Altairu/Altair-Nexus-Driver-Module/image.png

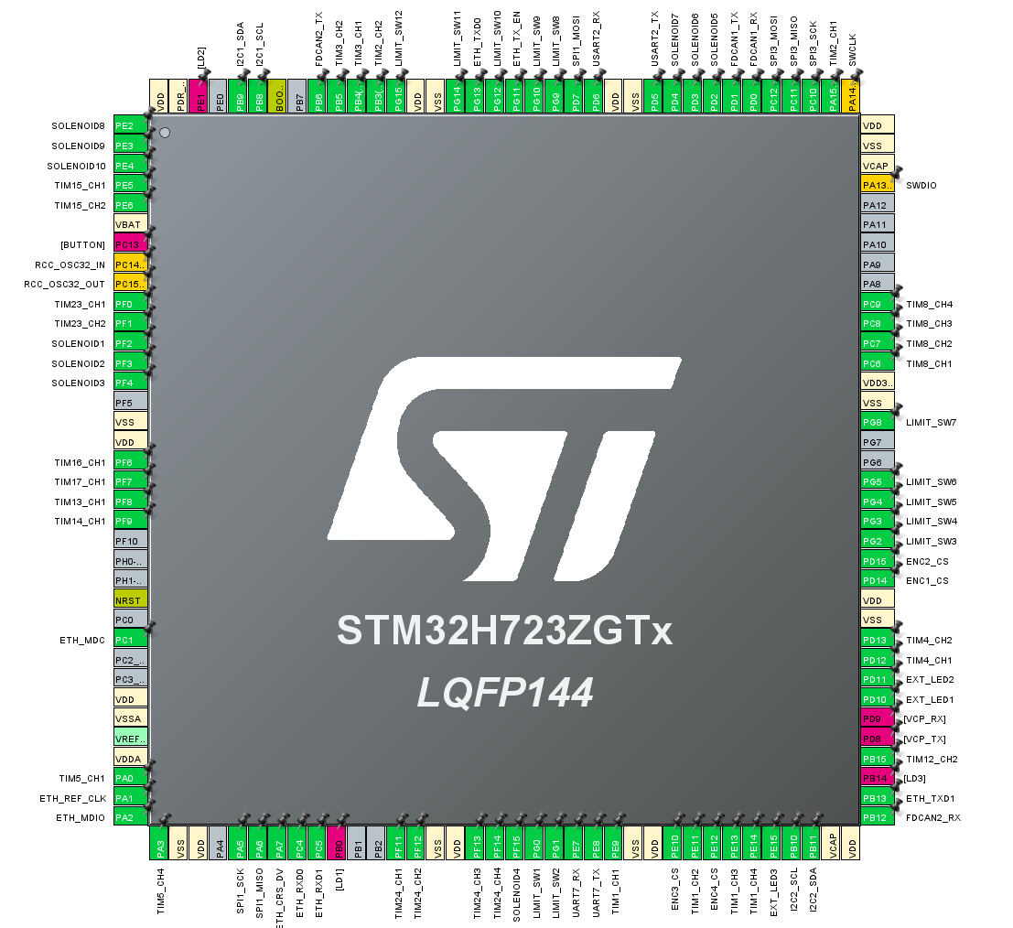
image.png
