Altairu/Altair-Nexus-Driver-Module/circuit/Altair Nexus Driver Module.kicad_sch

## KiCad design circuit/Altair Nexus Driver Module.kicad_sch (2026-10-21)

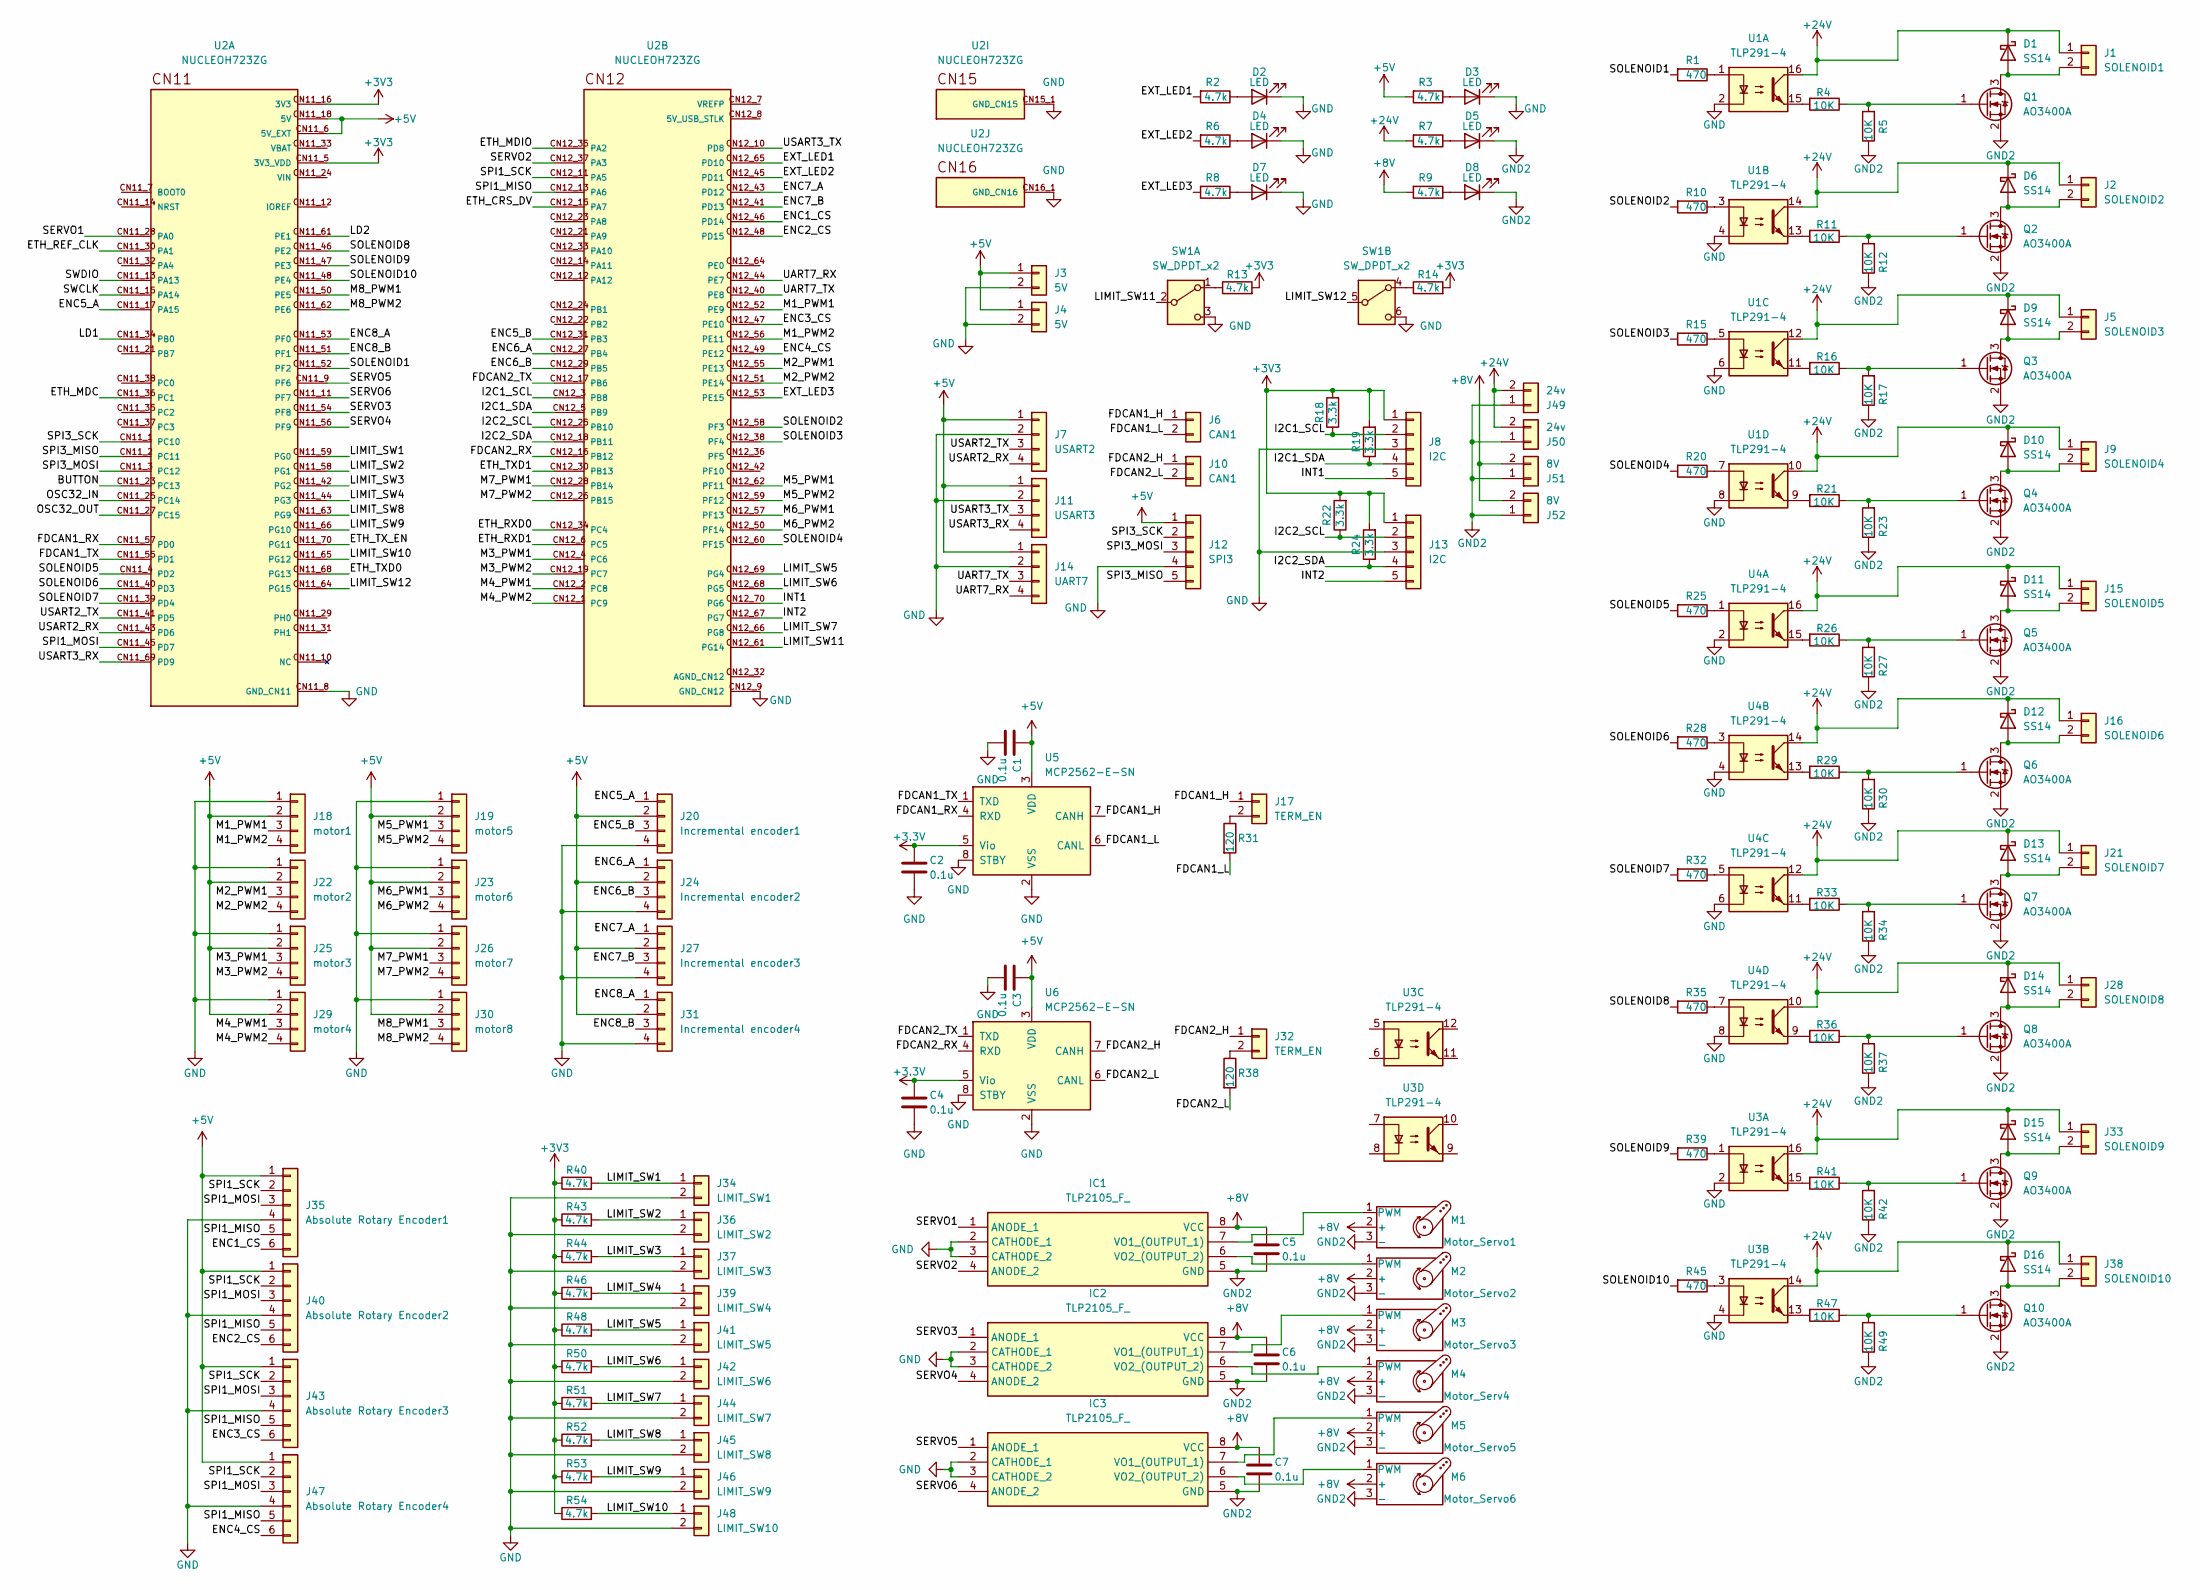
[picture p3: schematic Altair Nexus Driver Module.kicad_sch]

Parts:
C1, C2, C3, C4, C5, C6, C7: 0.1u; C_0603_1608Metric
D1, D6, D9, D10, D11, D12, D13, D14, D15, D16: SS14; D_SMA
D2, D3, D4, D5, D7, D8: LED
IC1, IC2, IC3: TLP2105_F_; TLP2105; Manufacturer_Part_Number TLP2105(F); Mouser Part Number 757-TLP2105(F)
J1: SOLENOID1; AMASS_XT30U-F_1x02_P5.0mm_Vertical
J2: SOLENOID2; AMASS_XT30U-F_1x02_P5.0mm_Vertical
J3, J4: 5V
J5: SOLENOID3; AMASS_XT30U-F_1x02_P5.0mm_Vertical
J6, J10: CAN1
J7: USART2
J8, J13: I2C
J9: SOLENOID4; AMASS_XT30U-F_1x02_P5.0mm_Vertical
J11: USART3
J12: SPI3
J14: UART7
J15: SOLENOID5; AMASS_XT30U-F_1x02_P5.0mm_Vertical
J16: SOLENOID6; AMASS_XT30U-F_1x02_P5.0mm_Vertical
J17, J32: TERM_EN; PinSocket_1x02_P2.54mm_Vertical
J18: motor1
J19: motor5
J20: Incremental encoder1
J21: SOLENOID7; AMASS_XT30U-F_1x02_P5.0mm_Vertical
J22: motor2
J23: motor6
J24: Incremental encoder2
J25: motor3
J26: motor7
J27: Incremental encoder3
J28: SOLENOID8; AMASS_XT30U-F_1x02_P5.0mm_Vertical
J29: motor4
J30: motor8
J31: Incremental encoder4
J33: SOLENOID9; AMASS_XT30U-F_1x02_P5.0mm_Vertical
J34: LIMIT_SW1
J35: Absolute Rotary Encoder1
J36: LIMIT_SW2
J37: LIMIT_SW3
J38: SOLENOID10; AMASS_XT30U-F_1x02_P5.0mm_Vertical
J39: LIMIT_SW4
J40: Absolute Rotary Encoder2
J41: LIMIT_SW5
J42: LIMIT_SW6
J43: Absolute Rotary Encoder3
J44: LIMIT_SW7
J45: LIMIT_SW8
J46: LIMIT_SW9
J47: Absolute Rotary Encoder4
J48: LIMIT_SW10
J49, J50: 24v
J51, J52: 8V
M1: Motor_Servo1; JST_XA_S03B-XASK-1_1x03_P2.50mm_Horizontal
M2: Motor_Servo2; JST_XA_S03B-XASK-1_1x03_P2.50mm_Horizontal
M3: Motor_Servo3; JST_XA_S03B-XASK-1_1x03_P2.50mm_Horizontal
M4: Motor_Serv4; JST_XA_S03B-XASK-1_1x03_P2.50mm_Horizontal
M5: Motor_Servo5; JST_XA_S03B-XASK-1_1x03_P2.50mm_Horizontal
M6: Motor_Servo6; JST_XA_S03B-XASK-1_1x03_P2.50mm_Horizontal
Q1, Q2, Q3, Q4, Q5, Q6, Q7, Q8, Q9, Q10: AO3400A; SOT-23
R1, R10, R15, R20, R25, R28, R32, R35, R39, R45: 470; R_0603_1608Metric
R2, R3, R6, R7, R8, R9: 4.7k; R_0603_1608Metric
R4, R5, R11, R12, R16, R17, R21, R23, R26, R27, R29, R30, R33, R34, R36, R37, R41, R42, R47, R49: 10K; R_0603_1608Metric
R13, R14, R40, R43, R44, R46, R48, R50, R51, R52, R53, R54: 4.7k
R18, R19, R22, R24: 3.3k
R31, R38: 120; R_0603_1608Metric
SW1: SW_DPDT_x2
U1, U3, U4: TLP291-4; SOIC-16_4.55x10.3mm_P1.27mm
U2: NUCLEOH723ZG; MODULE_NUCLEOH723ZG; PARTREV 2
U5, U6: MCP2562-E-SN; SOIC-8_3.9x4.9mm_P1.27mm

Connections:
+3.3V: C2.1, C4.1, U5.5 (Vio), U6.5 (Vio)
+3V3: J8.1, J13.1, R13.2, R14.2, R18.2, R19.2, R22.2, R24.2, R40.1, R43.1, R44.1, R46.1, R48.1, R50.1, R51.1, R52.1, R53.1, R54.1, U2.CN11_5 (3V3_VDD), U2.CN11_16 (3V3)
+5V: C1.1, C3.1, J3.1, J4.1, J7.1, J11.1, J12.1, J14.1, J18.2, J19.2, J20.2, J22.2, J23.2, J24.2, J25.2, J26.2, J27.2, J29.2, J30.2, J31.2, J35.1, J40.1, J43.1, J47.1, R3.2, U2.CN11_6 (5V_EXT), U2.CN11_18 (5V), U5.3 (VDD), U6.3 (VDD)
+8V: C5.1, C6.1, C7.1, IC1.8 (VCC), IC2.8 (VCC), IC3.8 (VCC), J51.2, J52.2, M1.2 (+), M2.2 (+), M3.2 (+), M4.2 (+), M5.2 (+), M6.2 (+), R9.2
+24V: D1.1 (K), D6.1 (K), D9.1 (K), D10.1 (K), D11.1 (K), D12.1 (K), D13.1 (K), D14.1 (K), D15.1 (K), D16.1 (K), J1.1, J2.1, J5.1, J9.1, J15.1, J16.1, J21.1, J28.1, J33.1, J38.1, J49.2, J50.2, R7.2, U1.10, U1.12, U1.14, U1.16, U3.14, U3.16, U4.10, U4.12, U4.14, U4.16
BUTTON: U2.CN11_23 (PC13)
ENC1_CS: J35.6, U2.CN12_46 (PD14)
ENC2_CS: J40.6, U2.CN12_48 (PD15)
ENC3_CS: J43.6, U2.CN12_47 (PE10)
ENC4_CS: J47.6, U2.CN12_49 (PE12)
ENC5_A: J20.1, U2.CN11_17 (PA15)
ENC5_B: J20.3, U2.CN12_31 (PB3)
ENC6_A: J24.1, U2.CN12_27 (PB4)
ENC6_B: J24.3, U2.CN12_29 (PB5)
ENC7_A: J27.1, U2.CN12_43 (PD12)
ENC7_B: J27.3, U2.CN12_41 (PD13)
ENC8_A: J31.1, U2.CN11_53 (PF0)
ENC8_B: J31.3, U2.CN11_51 (PF1)
ETH_CRS_DV: U2.CN12_15 (PA7)
ETH_MDC: U2.CN11_36 (PC1)
ETH_MDIO: U2.CN12_35 (PA2)
ETH_REF_CLK: U2.CN11_30 (PA1)
ETH_RXD0: U2.CN12_34 (PC4)
ETH_RXD1: U2.CN12_6 (PC5)
ETH_TXD0: U2.CN11_68 (PG13)
ETH_TXD1: U2.CN12_30 (PB13)
ETH_TX_EN: U2.CN11_70 (PG11)
EXT_LED1: R2.2, U2.CN12_65 (PD10)
EXT_LED2: R6.2, U2.CN12_45 (PD11)
EXT_LED3: R8.2, U2.CN12_53 (PE15)
FDCAN1_H: J6.1, J17.1, U5.7 (CANH)
FDCAN1_L: J6.2, R31.2, U5.6 (CANL)
FDCAN1_RX: U2.CN11_57 (PD0), U5.4 (RXD)
FDCAN1_TX: U2.CN11_55 (PD1), U5.1 (TXD)
FDCAN2_H: J10.1, J32.1, U6.7 (CANH)
FDCAN2_L: J10.2, R38.2, U6.6 (CANL)
FDCAN2_RX: U2.CN12_16 (PB12), U6.4 (RXD)
FDCAN2_TX: U2.CN12_17 (PB6), U6.1 (TXD)
GND: C1.2, C2.2, C3.2, C4.2, D2.1 (K), D3.1 (K), D4.1 (K), D7.1 (K), IC1.2 (CATHODE_1), IC1.3 (CATHODE_2), IC2.2 (CATHODE_1), IC2.3 (CATHODE_2), IC3.2 (CATHODE_1), IC3.3 (CATHODE_2), J3.2, J4.2, J7.2, J8.3, J11.2, J12.4, J13.3, J14.2, J18.1, J19.1, J20.4, J22.1, J23.1, J24.4, J25.1, J26.1, J27.4, J29.1, J30.1, J31.4, J34.2, J35.4, J36.2, J37.2, J39.2, J40.4, J41.2, J42.2, J43.4, J44.2, J45.2, J46.2, J47.4, J48.2, SW1.3 (C), SW1.6 (C), U1.2, U1.4, U1.6, U1.8, U2.CN11_8 (GND_CN11), U2.CN11_19 (GND_CN11), U2.CN11_20 (GND_CN11), U2.CN11_22 (GND_CN11), U2.CN11_49 (GND_CN11), U2.CN11_60 (GND_CN11), U2.CN12_9 (GND_CN12), U2.CN12_20 (GND_CN12), U2.CN12_39 (GND_CN12), U2.CN12_54 (GND_CN12), U2.CN12_63 (GND_CN12), U2.CN15_1 (GND_CN15), U2.CN15_2 (GND_CN15), U2.CN16_1 (GND_CN16), U2.CN16_2 (GND_CN16), U3.2, U3.4, U4.2, U4.4, U4.6, U4.8, U5.2 (VSS), U5.8 (STBY), U6.2 (VSS), U6.8 (STBY)
GND2: C5.2, C6.2, C7.2, D5.1 (K), D8.1 (K), IC1.5 (GND), IC2.5 (GND), IC3.5 (GND), J49.1, J50.1, J51.1, J52.1, M1.3 (-), M2.3 (-), M3.3 (-), M4.3 (-), M5.3 (-), M6.3 (-), Q1.2 (S), Q2.2 (S), Q3.2 (S), Q4.2 (S), Q5.2 (S), Q6.2 (S), Q7.2 (S), Q8.2 (S), Q9.2 (S), Q10.2 (S), R5.1, R12.1, R17.1, R23.1, R27.1, R30.1, R34.1, R37.1, R42.1, R49.1
I2C1_SCL: J8.2, R18.1, U2.CN12_3 (PB8)
I2C1_SDA: J8.4, R19.1, U2.CN12_5 (PB9)
I2C2_SCL: J13.2, R22.1, U2.CN12_25 (PB10)
I2C2_SDA: J13.4, R24.1, U2.CN12_18 (PB11)
INT1: J8.5, U2.CN12_70 (PG6)
INT2: J13.5, U2.CN12_67 (PG7)
LD1: U2.CN11_34 (PB0)
LD2: U2.CN11_61 (PE1)
LIMIT_SW1: J34.1, R40.2, U2.CN11_59 (PG0)
LIMIT_SW2: J36.1, R43.2, U2.CN11_58 (PG1)
LIMIT_SW3: J37.1, R44.2, U2.CN11_42 (PG2)
LIMIT_SW4: J39.1, R46.2, U2.CN11_44 (PG3)
LIMIT_SW5: J41.1, R48.2, U2.CN12_69 (PG4)
LIMIT_SW6: J42.1, R50.2, U2.CN12_68 (PG5)
LIMIT_SW7: J44.1, R51.2, U2.CN12_66 (PG8)
LIMIT_SW8: J45.1, R52.2, U2.CN11_63 (PG9)
LIMIT_SW9: J46.1, R53.2, U2.CN11_66 (PG10)
LIMIT_SW10: J48.1, R54.2, U2.CN11_65 (PG12)
LIMIT_SW11: SW1.2 (B), U2.CN12_61 (PG14)
LIMIT_SW12: SW1.5 (B), U2.CN11_64 (PG15)
M1_PWM1: J18.3, U2.CN12_52 (PE9)
M1_PWM2: J18.4, U2.CN12_56 (PE11)
M2_PWM1: J22.3, U2.CN12_55 (PE13)
M2_PWM2: J22.4, U2.CN12_51 (PE14)
M3_PWM1: J25.3, U2.CN12_4 (PC6)
M3_PWM2: J25.4, U2.CN12_19 (PC7)
M4_PWM1: J29.3, U2.CN12_2 (PC8)
M4_PWM2: J29.4, U2.CN12_1 (PC9)
M5_PWM1: J19.3, U2.CN12_62 (PF11)
M5_PWM2: J19.4, U2.CN12_59 (PF12)
M6_PWM1: J23.3, U2.CN12_57 (PF13)
M6_PWM2: J23.4, U2.CN12_50 (PF14)
M7_PWM1: J26.3, U2.CN12_28 (PB14)
M7_PWM2: J26.4, U2.CN12_26 (PB15)
M8_PWM1: J30.3, U2.CN11_50 (PE5)
M8_PWM2: J30.4, U2.CN11_62 (PE6)
unnamed: D1.2 (A), J1.2, Q1.3 (D)
unnamed: D2.2 (A), R2.1
unnamed: D3.2 (A), R3.1
unnamed: D4.2 (A), R6.1
unnamed: D5.2 (A), R7.1
unnamed: D6.2 (A), J2.2, Q2.3 (D)
unnamed: D7.2 (A), R8.1
unnamed: D8.2 (A), R9.1
unnamed: D9.2 (A), J5.2, Q3.3 (D)
unnamed: D10.2 (A), J9.2, Q4.3 (D)
unnamed: D11.2 (A), J15.2, Q5.3 (D)
unnamed: D12.2 (A), J16.2, Q6.3 (D)
unnamed: D13.2 (A), J21.2, Q7.3 (D)
unnamed: D14.2 (A), J28.2, Q8.3 (D)
unnamed: D15.2 (A), J33.2, Q9.3 (D)
unnamed: D16.2 (A), J38.2, Q10.3 (D)
unnamed: IC1.6 (VO2_(OUTPUT_2)), M2.1 (PWM)
unnamed: IC1.7 (VO1_(OUTPUT_1)), M1.1 (PWM)
unnamed: IC2.6 (VO2_(OUTPUT_2)), M4.1 (PWM)
unnamed: IC2.7 (VO1_(OUTPUT_1)), M3.1 (PWM)
unnamed: IC3.6 (VO2_(OUTPUT_2)), M6.1 (PWM)
unnamed: IC3.7 (VO1_(OUTPUT_1)), M5.1 (PWM)
unnamed: J17.2, R31.1
unnamed: J32.2, R38.1
unnamed: Q1.1 (G), R4.1, R5.2
unnamed: Q2.1 (G), R11.1, R12.2
unnamed: Q3.1 (G), R16.1, R17.2
unnamed: Q4.1 (G), R21.1, R23.2
unnamed: Q5.1 (G), R26.1, R27.2
unnamed: Q6.1 (G), R29.1, R30.2
unnamed: Q7.1 (G), R33.1, R34.2
unnamed: Q8.1 (G), R36.1, R37.2
unnamed: Q9.1 (G), R41.1, R42.2
unnamed: Q10.1 (G), R47.1, R49.2
unnamed: R1.1, U1.1
unnamed: R4.2, U1.15
unnamed: R10.1, U1.3
unnamed: R11.2, U1.13
unnamed: R13.1, SW1.1 (A)
unnamed: R14.1, SW1.4 (A)
unnamed: R15.1, U1.5
unnamed: R16.2, U1.11
unnamed: R20.1, U1.7
unnamed: R21.2, U1.9
unnamed: R25.1, U4.1
unnamed: R26.2, U4.15
unnamed: R28.1, U4.3
unnamed: R29.2, U4.13
unnamed: R32.1, U4.5
unnamed: R33.2, U4.11
unnamed: R35.1, U4.7
unnamed: R36.2, U4.9
unnamed: R39.1, U3.1
unnamed: R41.2, U3.15
unnamed: R45.1, U3.3
unnamed: R47.2, U3.13
unnamed: U2.CN11_10 (NC), U2.CN11_26 (NC), U2.CN11_67 (NC)
OSC32_IN: U2.CN11_25 (PC14)
OSC32_OUT: U2.CN11_27 (PC15)
SERVO1: IC1.1 (ANODE_1), U2.CN11_28 (PA0)
SERVO2: IC1.4 (ANODE_2), U2.CN12_37 (PA3)
SERVO3: IC2.1 (ANODE_1), U2.CN11_54 (PF8)
SERVO4: IC2.4 (ANODE_2), U2.CN11_56 (PF9)
SERVO5: IC3.1 (ANODE_1), U2.CN11_9 (PF6)
SERVO6: IC3.4 (ANODE_2), U2.CN11_11 (PF7)
SOLENOID1: R1.2, U2.CN11_52 (PF2)
SOLENOID2: R10.2, U2.CN12_58 (PF3)
SOLENOID3: R15.2, U2.CN12_38 (PF4)
SOLENOID4: R20.2, U2.CN12_60 (PF15)
SOLENOID5: R25.2, U2.CN11_4 (PD2)
SOLENOID6: R28.2, U2.CN11_40 (PD3)
SOLENOID7: R32.2, U2.CN11_39 (PD4)
SOLENOID8: R35.2, U2.CN11_46 (PE2)
SOLENOID9: R39.2, U2.CN11_47 (PE3)
SOLENOID10: R45.2, U2.CN11_48 (PE4)
SPI1_MISO: J35.5, J40.5, J43.5, J47.5, U2.CN12_13 (PA6)
SPI1_MOSI: J35.3, J40.3, J43.3, J47.3, U2.CN11_45 (PD7)
SPI1_SCK: J35.2, J40.2, J43.2, J47.2, U2.CN12_11 (PA5)
SPI3_MISO: J12.5, U2.CN11_2 (PC11)
SPI3_MOSI: J12.3, U2.CN11_3 (PC12)
SPI3_SCK: J12.2, U2.CN11_1 (PC10)
SWCLK: U2.CN11_15 (PA14)
SWDIO: U2.CN11_13 (PA13)
UART7_RX: J14.4, U2.CN12_44 (PE7)
UART7_TX: J14.3, U2.CN12_40 (PE8)
USART2_RX: J7.4, U2.CN11_43 (PD6)
USART2_TX: J7.3, U2.CN11_41 (PD5)
USART3_RX: J11.4, U2.CN11_69 (PD9)
USART3_TX: J11.3, U2.CN12_10 (PD8)
