Altairu/Altair-Nexus-Driver-Module/firmware/Altair_Nexus_Driver_Module/Altair_Nexus_Driver_Module.ioc

Mcu.UserName=STM32H723ZGTx
PA0.Signal=S_TIM5_CH1
PA1.Signal=ETH_REF_CLK
PA13(JTMS/SWDIO).GPIO_Label=SWDIO
PA13(JTMS/SWDIO).Signal=DEBUG_JTMS-SWDIO
PA14(JTCK/SWCLK).GPIO_Label=SWCLK
PA14(JTCK/SWCLK).Signal=DEBUG_JTCK-SWCLK
PA15(JTDI).Signal=S_TIM2_CH1_ETR
PA2.Signal=ETH_MDIO
PA3.Signal=S_TIM5_CH4
PA5.Signal=SPI1_SCK
PA6.Signal=SPI1_MISO
PA7.Signal=ETH_CRS_DV
PB0.Signal=GPIO_Output
PB10.Signal=I2C2_SCL
PB11.Signal=I2C2_SDA
PB12.Signal=FDCAN2_RX
PB13.Signal=ETH_TXD1
PB14.Signal=S_TIM12_CH1
PB15.Signal=S_TIM12_CH2
PB3(JTDO/TRACESWO).Signal=S_TIM2_CH2
PB4(NJTRST).Signal=S_TIM3_CH1
PB5.Signal=S_TIM3_CH2
PB6.Signal=FDCAN2_TX
PB8.Signal=I2C1_SCL
PB9.Signal=I2C1_SDA
PC1.Signal=ETH_MDC
PC10.Signal=SPI3_SCK
PC11.Signal=SPI3_MISO
PC12.Signal=SPI3_MOSI
PC13.Signal=GPIO_Input
PC14-OSC32_IN.Signal=RCC_OSC32_IN
PC15-OSC32_OUT.Signal=RCC_OSC32_OUT
PC4.Signal=ETH_RXD0
PC5.Signal=ETH_RXD1
PC6.Signal=S_TIM8_CH1
PC7.Signal=S_TIM8_CH2
PC8.Signal=S_TIM8_CH3
PC9.Signal=S_TIM8_CH4
PD0.Signal=FDCAN1_RX
PD1.Signal=FDCAN1_TX
PD10.GPIO_Label=EXT_LED1
PD10.Signal=GPIO_Output
PD11.GPIO_Label=EXT_LED2
PD11.Signal=GPIO_Output
PD12.Signal=S_TIM4_CH1
PD13.Signal=S_TIM4_CH2
PD14.GPIO_Label=ENC1_CS
PD14.Signal=GPIO_Output
PD15.GPIO_Label=ENC2_CS
PD15.Signal=GPIO_Output
PD2.GPIO_Label=SOLENOID5
PD2.Signal=GPIO_Output
PD3.GPIO_Label=SOLENOID6
PD3.Signal=GPIO_Output
PD4.GPIO_Label=SOLENOID7
PD4.Signal=GPIO_Output
PD5.Signal=USART2_TX
PD6.Signal=USART2_RX
PD7.Signal=SPI1_MOSI
PD8.Signal=USART3_TX
PD9.Signal=USART3_RX
PE1.Signal=GPIO_Output
PE10.GPIO_Label=ENC3_CS
PE10.Signal=GPIO_Output
PE11.Signal=S_TIM1_CH2
PE12.GPIO_Label=ENC4_CS
PE12.Signal=GPIO_Output
PE13.Signal=S_TIM1_CH3
PE14.Signal=S_TIM1_CH4
PE15.GPIO_Label=EXT_LED3
PE15.Signal=GPIO_Output
PE2.GPIO_Label=SOLENOID8
PE2.Signal=GPIO_Output
PE3.GPIO_Label=SOLENOID9
PE3.Signal=GPIO_Output
PE4.GPIO_Label=SOLENOID10
PE4.Signal=GPIO_Output
PE5.Signal=S_TIM15_CH1
PE6.Signal=S_TIM15_CH2
PE7.Signal=UART7_RX
PE8.Signal=UART7_TX
PE9.Signal=S_TIM1_CH1
PF0.Signal=TIM23_CH1
PF1.Signal=S_TIM23_CH2
PF11.Signal=TIM24_CH1
PF12.Signal=S_TIM24_CH2
PF13.Signal=S_TIM24_CH3
PF14.Signal=S_TIM24_CH4
PF15.GPIO_Label=SOLENOID4
PF15.Signal=GPIO_Output
PF2.GPIO_Label=SOLENOID1
PF2.Signal=GPIO_Output
PF3.GPIO_Label=SOLENOID2
PF3.Signal=GPIO_Output
PF4.GPIO_Label=SOLENOID3
PF4.Signal=GPIO_Output
PF6.Signal=S_TIM16_CH1
PF7.Signal=S_TIM17_CH1
PF8.Signal=S_TIM13_CH1
PF9.Signal=S_TIM14_CH1
PG0.GPIO_Label=LIMIT_SW1
PG0.Signal=GPIO_Input
PG1.GPIO_Label=LIMIT_SW2
PG1.Signal=GPIO_Input
PG10.GPIO_Label=LIMIT_SW9
PG10.Signal=GPIO_Input
PG11.Signal=ETH_TX_EN
PG12.GPIO_Label=LIMIT_SW10
PG12.Signal=GPIO_Input
PG13.Signal=ETH_TXD0
PG14.GPIO_Label=LIMIT_SW11
PG14.Signal=GPIO_Input
PG15.GPIO_Label=LIMIT_SW12
PG15.Signal=GPIO_Input
PG2.GPIO_Label=LIMIT_SW3
PG2.Signal=GPIO_Input
PG3.GPIO_Label=LIMIT_SW4
PG3.Signal=GPIO_Input
PG4.GPIO_Label=LIMIT_SW5
PG4.Signal=GPIO_Input
PG5.GPIO_Label=LIMIT_SW6
PG5.Signal=GPIO_Input
PG8.GPIO_Label=LIMIT_SW7
PG8.Signal=GPIO_Input
PG9.GPIO_Label=LIMIT_SW8
PG9.Signal=GPIO_Input
