Altairu/Altair-Nexus-Driver-Module/(commit log)

2026-10-21 refactor: move KiCad project files into circuit subdirectory
2026-10-21 feat: add initial KiCad schematic, project files, and history tracking for Altair Nexus Driver Module
2026-10-21 feat: 回路設計
