Altairu/Altair-Nexus-Driver-Module/(notices)

Notices in the files:
firmware/Altair_Nexus_Driver_Module/Core/Inc/main.h:
Copyright (c) 2026 STMicroelectronics.
All rights reserved.
This software is licensed under terms that can be found in the LICENSE file
